python-ugame/ugame-10-hardware/(list of files, drawings)

Other design files:
fritzing/ugame-10.fz
