python-ugame/ugame-10-hardware/(commit log)

2018-01-27 Clean up the schematic and add schematic SVG
    [ugame-10.fz]
2018-02-09 Add an OpenSCAD model
    [ugame-10.scad]
2018-02-11 Add assembly notes
2018-02-11 Fix gerber files
    [ugame-10_contour.gm1, ugame-10_copperBottom.gbl, ugame-10_copperTop.gtl, ugame-10_maskBottom.gbs, ugame-10_maskTop.gts, ugame-10_pasteMaskBottom.gbp, ugame-10_pasteMaskTop.gtp, ugame-10_silkBottom.gbo]
2018-02-25 Make compitible with kitspace.org
    [1-click-bom.tsv]
2018-02-25 Improve BOM
    [1-click-bom.tsv]
